starlingcode/analog-via/(commit log)

2025-01-03 V1 prototype production 12-15-24
    [analog-via.kicad_pcb, analog-via.kicad_sch, bom.csv, designators.csv, positions.csv]
2025-01-04 rotated op amp packages and corrected power supply issues, ratsnest still needs corrections
    [analog-via.kicad_pcb, analog-via.kicad_sch]
2025-05-18 pre-re-annotation, completed next rev schematic capture
    [analog-via.kicad_sch]
2025-05-19 v2 routed, no drc yet
    [analog-via.kicad_pcb, slew.kicad_pcb, slew.kicad_sch]
2025-05-25 v2 proto passes DRC
    [analog-via.kicad_pcb, analog-via.kicad_sch]
2025-05-25 update servo integrator to provide additional configuration options and add missing decoupling caps
    [analog-via.kicad_pcb, analog-via.kicad_sch]
2025-08-13 update schematic with Will's debugging notes
