starlingcode/analog-via/(notices)

Notices in the files:
analog-via.kicad_pcb:
CC BY-SA-NC 2025
